sahannt98/Weight-Scale-using-Load-Cells/(list of files, drawings)

Other design files:
Schematic Diagram.DSN
